LSG-Microcontroller-EMobility/72Volts-Charger-Cutoff-System/Monitoraggio_Batterie_LiFePO4_ATmega328P.docx

# Monitoraggio di 6 batterie LiFePO₄ con ATmega328P

Dimensionamento definitivo dei partitori resistivi per gli ingressi ADC

Configurazione di riferimento

Pacco: 6 batterie LiFePO₄ da 12 V nominali, ciascuna 4S, collegate in serie.

Tensione massima teorica per batteria: 14,6 V. Tensione massima teorica del pacco: 87,6 V.

Ultimo canale dimensionato a 88,0 V per mantenere un piccolo margine.

Microcontrollore: ATmega328P alimentato a 5 V; massa del pacco e GND del microcontrollore comuni.

Obiettivo: circa 3,7-3,8 V sul pin ADC alla tensione massima del relativo nodo cumulativo.

# 1. Architettura di misura

Le sei tensioni vengono misurate rispetto al negativo comune del pacco. Non si misura direttamente ogni batteria tra i suoi due morsetti: si misurano invece i sei nodi cumulativi e le tensioni delle singole batterie vengono ricavate per differenza nel firmware.

Nodi cumulativi

Nodo 1 = 14,6 V max

Nodo 2 = 29,2 V max

Nodo 3 = 43,8 V max

Nodo 4 = 58,4 V max

Nodo 5 = 73,0 V max

Nodo 6 = 87,6 V max (dimensionamento elettrico verificato fino a 88,0 V)

## Schema di ciascun canale ADC

Nodo cumulativo batteria
|
100 kΩ (Rhigh)
|
+--------------------> pin ADC ATmega328P
| |
Rlow 100 nF
| |
GND GND

# 2. Tabella definitiva dei partitori

Canale | Batterie cumulative | Vin max | Rhigh | Rlow | VADC max | I ramo | Rth
ADC1 | 1 | 14,6 V | 100 kΩ | 34,8 kΩ | 3,769 V | 0,108 mA | 25,82 kΩ
ADC2 | 2 | 29,2 V | 100 kΩ | 14,7 kΩ | 3,742 V | 0,255 mA | 12,82 kΩ
ADC3 | 3 | 43,8 V | 100 kΩ | 9,31 kΩ | 3,730 V | 0,401 mA | 8,52 kΩ
ADC4 | 4 | 58,4 V | 100 kΩ | 6,81 kΩ | 3,723 V | 0,547 mA | 6,38 kΩ
ADC5 | 5 | 73,0 V | 100 kΩ | 5,36 kΩ | 3,714 V | 0,693 mA | 5,09 kΩ
ADC6 | 6 | 88,0 V* | 100 kΩ | 4,42 kΩ | 3,725 V | 0,843 mA | 4,23 kΩ

* A 87,6 V reali, il canale ADC6 fornisce circa 3,708 V. Il valore di 88,0 V è usato soltanto come margine di progetto.

Condensatori sugli ingressi ADC

Montare 1 condensatore ceramico da 100 nF tra ciascun nodo ADC e GND: 6 condensatori in totale.

Il condensatore è quindi in parallelo alla Rlow del relativo canale.

Tensione nominale consigliata: almeno 16 V; 25 V è altrettanto adatto.

Posizionare il condensatore fisicamente vicino al pin ADC del microcontrollore.

# 3. Componenti consigliati

- Rhigh: 6 × 100 kΩ, metal film, THT/assiale, tolleranza 1% o migliore, potenza nominale almeno 1/4 W.
- Rlow: 34,8 kΩ; 14,7 kΩ; 9,31 kΩ; 6,81 kΩ; 5,36 kΩ; 4,42 kΩ. Valori E96, metal film, THT/assiali.
- Per una misura più accurata delle singole batterie, soprattutto se usata per un cutoff, preferire resistenze 0,1% oppure calibrare ogni canale in firmware con un multimetro affidabile.
- Condensatori: 6 × 100 nF ceramici, almeno 16 V, uno per ogni ingresso ADC.
- La massima dissipazione su una Rhigh è circa 71 mW sul canale ADC6 a 88 V: 1/4 W è sufficiente per potenza. Verificare comunque sul datasheet della resistenza una tensione di lavoro ammessa superiore a circa 85 V; è preferibile un componente con rating di almeno 100 V, meglio 200 V.

# 4. Indicazioni per l’ADC dell’ATmega328P

L’ATmega328P è ottimizzato per sorgenti ADC con impedenza relativamente bassa. Il condensatore da 100 nF è importante perché fornisce localmente la carica richiesta dal condensatore sample-and-hold interno durante la conversione. Nel presente progetto le tensioni delle batterie variano lentamente, quindi questa soluzione è adatta.

- Dopo il cambio di canale ADC è prudente scartare la prima conversione e utilizzare le successive.
- Per ridurre il rumore, effettuare una media di 8-16 conversioni per canale.
- Per la massima risoluzione a 10 bit, mantenere il clock ADC nel campo raccomandato dal datasheet. Esempio: circa 125 kHz è una scelta tipica.
- Se Vref coincide con VCC = 5 V, la precisione finale dipende anche dalla precisione e stabilità dei 5 V. Per misure accurate, misurare Vref reale o calibrare il fattore di scala nel firmware.

# 5. Formule per il firmware

Conversione del valore ADC

VADC = ADC_code × Vref / 1023

Vnodo = VADC × (Rhigh + Rlow) / Rlow

con Rhigh = 100 kΩ e Rlow specifica del canale.

Una volta ricostruite le sei tensioni cumulative V1...V6, le tensioni delle singole batterie sono:

Tensioni delle singole batterie

B1 = V1

B2 = V2 - V1

B3 = V3 - V2

B4 = V4 - V3

B5 = V5 - V4

B6 = V6 - V5

Nota sulla precisione: poiché B2...B6 sono ottenute sottraendo due misure cumulative, gli errori dei due canali si combinano. Per una funzione di protezione/cutoff è consigliata una calibrazione per canale e una soglia firmware con isteresi, evitando di usare una soglia esattamente coincidente con il limite nominale della batteria.

# 6. Assorbimento dei partitori

Alla massima tensione indicata, la somma delle correnti dei sei rami è circa 2,85 mA. Poiché i partitori sono collegati a nodi cumulativi, il carico sul pacco non è perfettamente simmetrico: la batteria più vicina al negativo comune è interessata dalla somma delle correnti di tutti i rami.

Ordine di grandezza su una settimana

Caso peggiore teorico sulla batteria inferiore: 2,85 mA × 168 h ≈ 0,48 Ah.

Su una batteria da 20 Ah corrisponde a circa il 2,4% della capacità nominale.

Per permanenze dell’ordine di una settimana il consumo è accettabile, ma se il sistema restasse collegato per periodi molto più lunghi sarebbe opportuno ridurre il carico o commutare i partitori.

# 7. Cablaggio e verifiche prima dell’uso

- Il negativo del pacco batterie deve essere collegato al GND dell’ATmega328P se l’intero sistema è progettato con massa comune e alimentazione non isolata.
- Verificare con multimetro ogni nodo cumulativo prima di collegarlo all’ADC.
- Verificare prima il funzionamento con tensioni ridotte o con alimentatore da banco, quindi aumentare progressivamente la tensione.
- Non collegare mai direttamente un nodo da 14,6-88 V a un pin ADC: il pin deve essere collegato esclusivamente al nodo centrale del relativo partitore.
- Curare isolamento, distanze e cablaggio della parte ad alta tensione del pacco. 88 V DC richiedono attenzione durante montaggio, misura e manutenzione.

# 8. Riepilogo operativo

Configurazione da realizzare

Rhigh su tutti i canali: 100 kΩ.

Rlow: 34,8 kΩ / 14,7 kΩ / 9,31 kΩ / 6,81 kΩ / 5,36 kΩ / 4,42 kΩ.

1 × 100 nF da ogni pin ADC a GND.

Resistenze THT/assiali metal film, preferibilmente 0,1% per protezione precisa oppure 1% con calibrazione software.

Misura dei 6 nodi cumulativi; ricostruzione delle 6 tensioni individuali per differenza.

ADC6 dimensionato a 88,0 V; VADC max ≈ 3,725 V.

Monitoraggio batterie LiFePO₄ - ATmega328P - Dimensionamento partitori ADC
