LSG-Microcontroller-EMobility/72Volts-Charger-Cutoff-System/(commit log)

2026-09-13 fix: filtra le letture e conferma le anomalie prima dello sgancio
    Media 16 letture per canale, scartando la prima conversione.
    Richiede tre scansioni anomale consecutive sulla stessa batteria per almeno 500 ms.
    Azzera le conferme quando la lettura torna regolare.
    Usa gli stessi valori per controllo e debug, registrando la causa dello sgancio.
    Mantiene soglie invariate, debug attivo e RF disattivata.
    [72Volts-Charger-Cutoff-System.ino]
2026-10-14 docs: document battery cutoff logic and firmware behavior
